2062380497-bit/51_uA/395724d5ed1f723bc839358d4bc2e69d.jpg

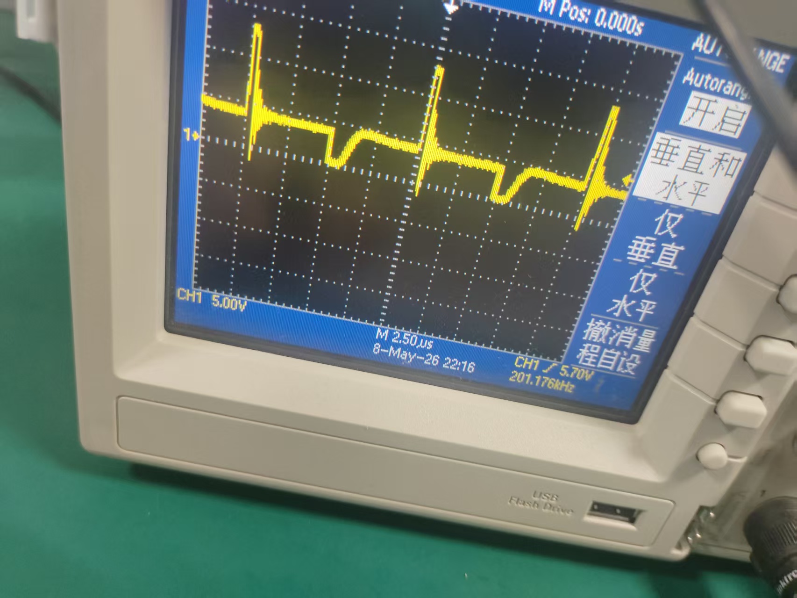
395724d5ed1f723bc839358d4bc2e69d.jpg
