2062380497-bit/51_uA/2ae99145ce11821d6db8bae6e3e0aa41.jpg

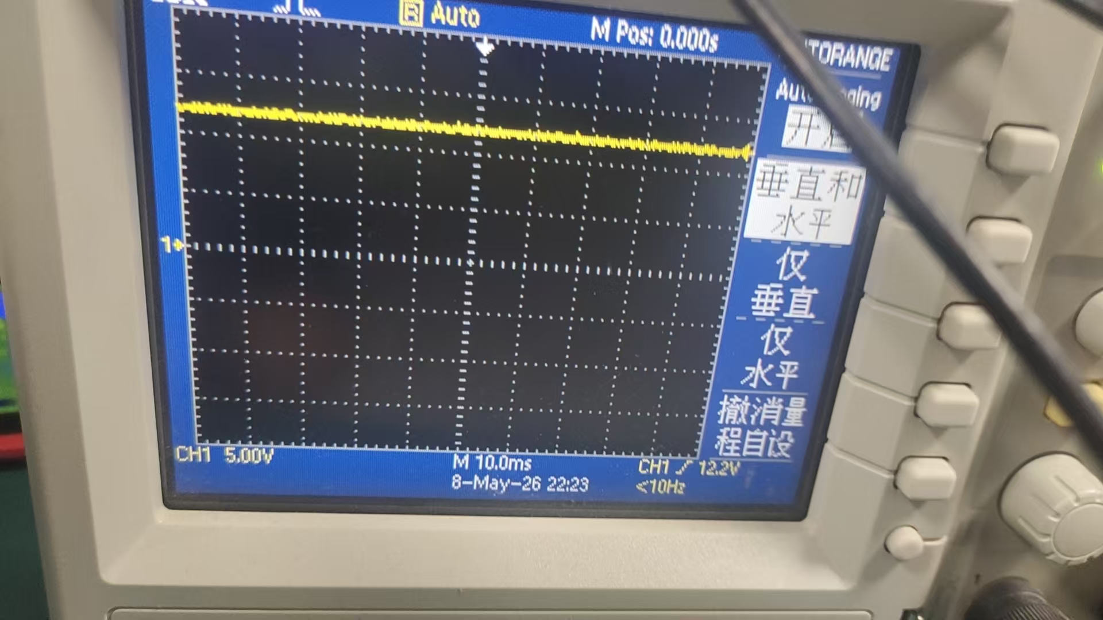
2ae99145ce11821d6db8bae6e3e0aa41.jpg
