2062380497-bit/51_uA/BOOST_实验任务与目的.md

# BOOST 实验任务与目的

## 1. 实验背景
本项目当前目标不是做稳压电源，而是获得并优化电感后开关节点的脉冲电压特性。

关注节点：电感后、二极管前的开关节点（SW 节点）。

---

## 2. 总目标
1. 在可重复条件下获得稳定的高幅值脉冲电压。
2. 明确频率和占空比对脉冲平台电压、尖峰、波形形态的影响规律。
3. 形成一组可直接复用的推荐参数（频率、占空比、器件组合）。

---

## 3. 任务清单（要做事情 + 目的）

### 任务 1：确认测量方法
- 要做事情：
  - 示波器探头测 SW 节点，地线尽量短。
  - 区分 SW 节点与二极管后输出节点，避免混测。
- 目的：
  - 保证波形判断对象正确，避免把输出直流误判为开关脉冲。
- 验收标准：
  - SW 节点可见明显开关脉冲与边沿尖峰。

### 任务 2：固定频率，扫描占空比
- 要做事情：
  - 先固定频率在 80 kHz 或 100 kHz。
  - 占空比从 30% 逐步增加到 75%，每步 5%。
  - 每个点记录：高平台电压、尖峰峰值、低平台电压、器件温升主观感受。
- 目的：
  - 建立占空比与脉冲幅值之间的关系，找到有效区间。
- 验收标准：
  - 输出一张 D-电压变化表，能看出明显趋势和拐点。

### 任务 3：固定占空比，扫描频率
- 要做事情：
  - 固定占空比在 55%（可再补测 45%、65%）。
  - 频率从 40 kHz 扫到 200 kHz，建议步进 10 kHz 或 20 kHz。
  - 记录同样指标：平台电压、尖峰、低平台、温升。
- 目的：
  - 找到本硬件上的最优频段，而不是默认频率越高越好。
- 验收标准：
  - 输出一张 f-电压变化表，得到推荐频率范围。

### 任务 4：验证器件限制
- 要做事情：
  - 对比不同占空比下开关管温升与波形变化。
  - 观察是否出现继续加占空比但平台电压不再上升的现象。
- 目的：
  - 判断当前三极管与二极管是否进入性能瓶颈。
- 验收标准：
  - 明确系统进入瓶颈的大致占空比区间。

### 任务 5：评估输出侧电容影响
- 要做事情：
  - 在 100 nF 条件下完成基线测试。
  - 选做：替换为 1 uF / 10 uF 做对比（若实验允许改板）。
- 目的：
  - 分离“SW 节点脉冲特性”与“输出储能能力”的影响。
- 验收标准：
  - 形成不同电容条件下波形与电压结果对照。

### 任务 6：形成推荐参数
- 要做事情：
  - 根据扫描结果确定 1 组主参数和 1 组备选参数。
  - 标注使用场景（高幅值优先 / 温升优先 / 稳定性优先）。
- 目的：
  - 让后续开发直接复用，不再重复试错。
- 验收标准：
  - 输出最终参数结论并写入项目记录。

---

## 4. 数据记录模板（建议每个测试点都填）
| 序号 | 频率 (kHz) | 占空比 (%) | SW 高平台 (V) | SW 尖峰峰值 (V) | SW 低平台 (V) | 输入电压 (V) | 备注 |
|---|---:|---:|---:|---:|---:|---:|---|
| 1 |  |  |  |  |  |  |  |
| 2 |  |  |  |  |  |  |  |
| 3 |  |  |  |  |  |  |  |

---

## 5. 风险与注意事项
1. 不要把 SW 节点波形当作稳压输出判断依据。
2. 占空比不建议长期超过 80%，避免器件过热。
3. 示波器长地线会放大尖峰观测值，优先使用短地弹簧。
4. 若出现波形突变或电压回落，优先排查器件温升与驱动能力。

---

## 6. 预期输出成果
1. 频率-占空比-电压三者关系的实验结论。
2. 至少 1 组可复现的推荐参数。
3. 后续优化方向（是否需要更换二极管/开关器件）。
