2062380497-bit/51_uA/image copy 2.png

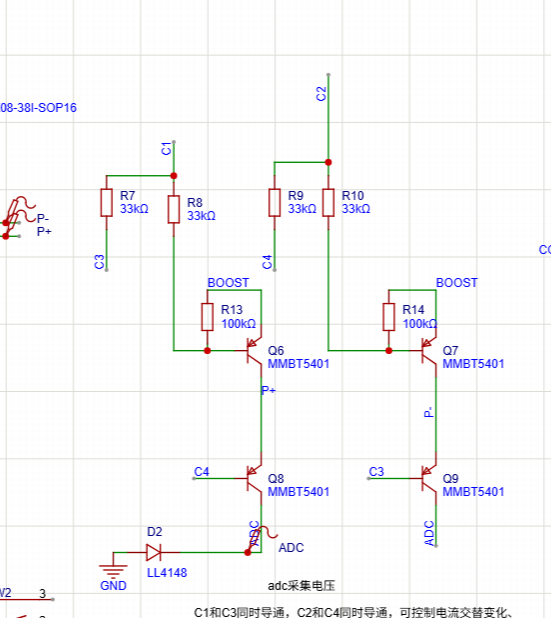
image copy 2.png
