2062380497-bit/51_uA/image copy.png

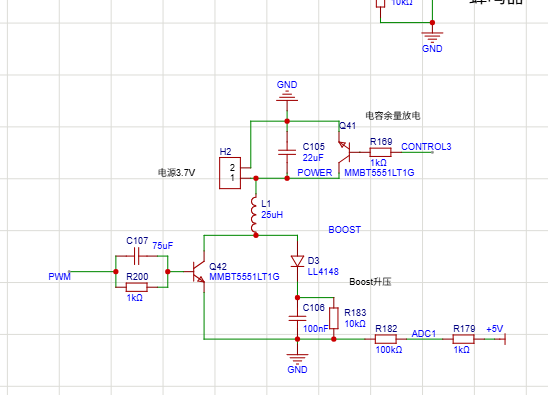
image copy.png
