2062380497-bit/51_uA/image.png

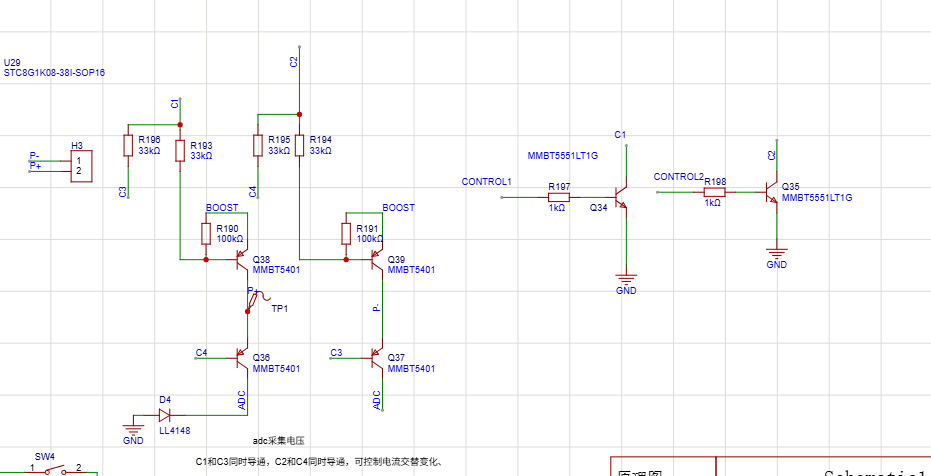
image.png
