2062380497-bit/51_uA/SCH_Schematic1_1-P1_2026-04-26.png

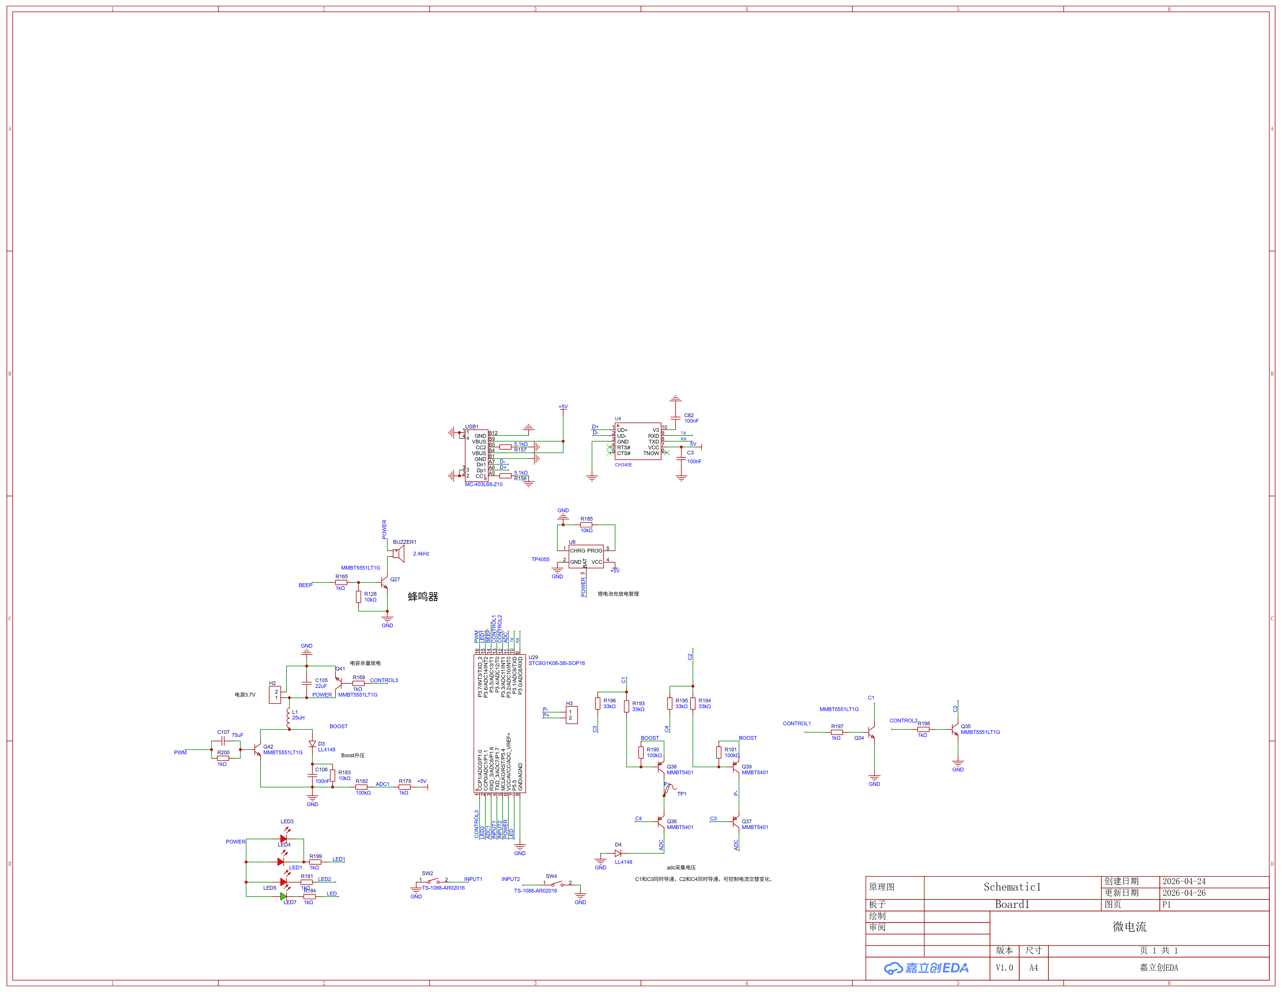
SCH_Schematic1_1-P1_2026-04-26.png
