2062380497-bit/51_uA/BOM_Board1_Schematic1_2026-04-26.xlsx

No. | Quantity | Comment | Designator | Footprint | Value | Manufacturer Part | Manufacturer | Supplier Part | Supplier
1 | 1 | 2.4kHz | BUZZER1 | BUZ-TH_BD12.0-P7.60-D0.6-FD | 2.4kHz | TMB12A05 | 华能 | C96093 | LCSC
2 | 2 | 100nF | C3,C82 | C0603 | 100nF | CGA0603X7R104K500JT | HRE(芯声) | C6119867 | LCSC
3 | 1 | 22uF | C105 | C0603 | 22uF | CL10A226MQ8NRNC | SAMSUNG(三星) | C59461 | LCSC
4 | 1 | 100nF | C106 | C0805 | 100nF | CC0805KRX7R9BB104 | YAGEO(国巨) | C49678 | LCSC
5 | 1 | 75uF | C107 | C0603 | 75uF
6 | 2 | LL4148 | D3,D4 | LL-34_L3.5-W1.5-RD |  | LL4148 | MDD(辰达半导体) | C435829 | LCSC
7 | 2 | HDR-F_2.54_1x2P | H2,H3 | HDR-TH_2P-P2.54-V-F |  |  |  | C49661
8 | 1 | 25uH | L1 | L0603 | 25uH
9 | 3 | LED_0603-R | LED3,LED4,LED5 | LED_0603
10 | 1 | LED_0603-G | LED7 | LED_0603
11 | 5 | MMBT5551LT1G | Q27,Q34,Q35,Q41,Q42 | SOT-23-3_L3.0-W1.7-P0.95-LS2.9-BR |  | MMBT5551LT1G | onsemi(安森美) | C41095 | LCSC
12 | 4 | MMBT5401 | Q36,Q37,Q38,Q39 | SOT-23-3_L2.9-W1.3-P1.90-LS2.4-BR |  | MMBT5401 | JSMSEMI(杰盛微) | C916371 | LCSC
13 | 3 | 10kΩ | R128,R183,R185 | R0603 | 10kΩ | 0603WAF1002T5E | UNI-ROYAL(厚声) | C25804 | LCSC
14 | 2 | 5.1kΩ | R157,R158 | R0603 | 5.1kΩ | 0603WAF5101T5E | UNI-ROYAL(厚声) | C23186 | LCSC
15 | 1 | 1kΩ | R165 | R0603 | 1kΩ | RC0603FR-071KL | YAGEO(国巨) | C22548 | LCSC
16 | 8 | 1kΩ | R169,R179,R181,R184,R197,R198,R199,R200 | R0603 | 1kΩ | 0603WAF1001T5E | UNI-ROYAL(厚声) | C21190 | LCSC
17 | 3 | 100kΩ | R182,R190,R191 | R0603 | 100kΩ | 0603WAF1003T5E | UNI-ROYAL(厚声) | C25803 | LCSC
18 | 4 | 33kΩ | R193,R194,R195,R196 | R0603 | 33kΩ | 0603WAF3302T5E | UNI-ROYAL(厚声) | C4216 | LCSC
19 | 2 | TS-1088-AR02016 | SW2,SW4 | SW-SMD_L3.9-W3.0-P4.45 |  | TS-1088-AR02016 | XUNPU(讯普) | C720477 | LCSC
20 | 1 | Test-Point | TP1 | Test-Point-0.5mm
21 | 1 | CH340E | U4 | MSOP-10_L3.0-W3.0-P0.50-LS5.0-BL |  | CH340E | WCH(南京沁恒) | C99652 | LCSC
22 | 1 | TP4055 | U6 | SOT-23-5_L3.0-W1.7-P0.95-LS2.8-BR |  | TP4055 | TOPPOWER(南京拓微) | C28441 | LCSC
23 | 1 | STC8G1K08-38I-SOP16 | U29 | SOP-16_L9.9-W3.9-P1.27-LS6.0-BL |  | STC8G1K08-38I-SOP16 | STC | C2901876 | LCSC
24 | 1 | MC-403L68-Z10 | USB1 | USB-TYPE-C-SMD_MC-403L68-Z10 |  | MC-403L68-Z10 | HANBO(汉博) | C47326496 | LCSC
