2062380497-bit/51_uA/SCH_Schematic1_2026-04-26.pdf

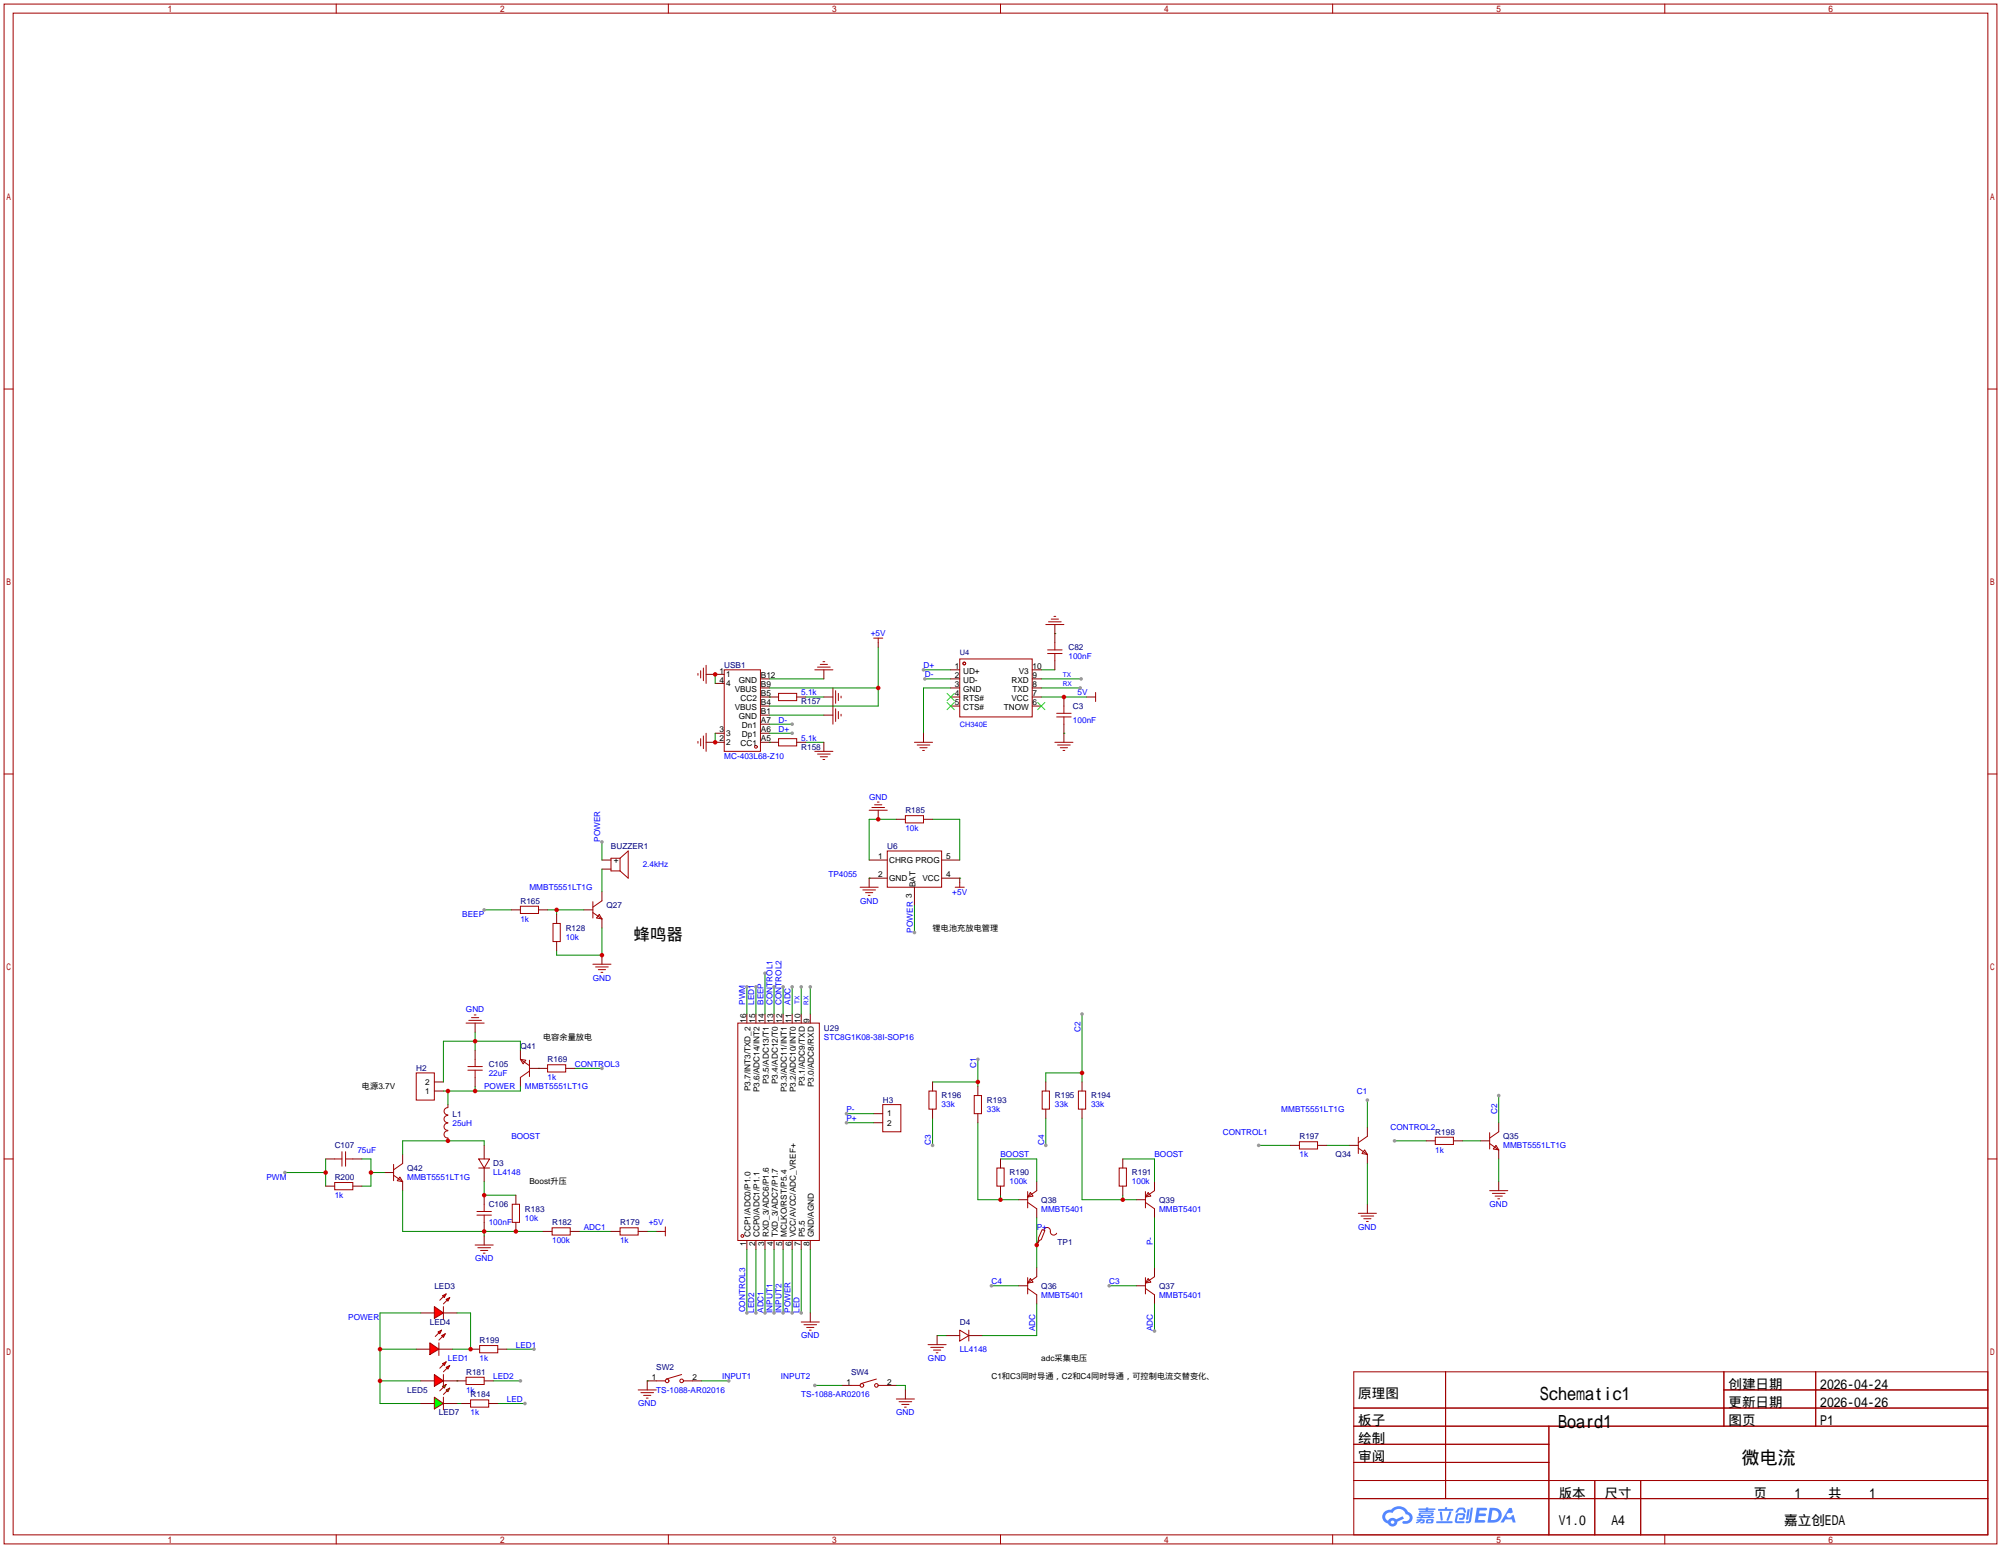
[picture p7: page 1]

原理图 | Schematic1 | 创建日期 | 2026-04-24

更新日期 | 2026-04-26

板子 | Board1 | 图页 | P1
绘制 | | 微电流
审阅

V1.0 | A4 | 嘉立创EDA
