2062380497-bit/51_uA/(commit log)

2026-05-07 微电流v0.5
2026-05-09 v1.1,整合后的
2026-05-09 v1.1新
